Rashiq1618/SS26_Prototyping_GroupE2_Team_E1/README.md

<div align="center">

  Animated Title

<br><br>

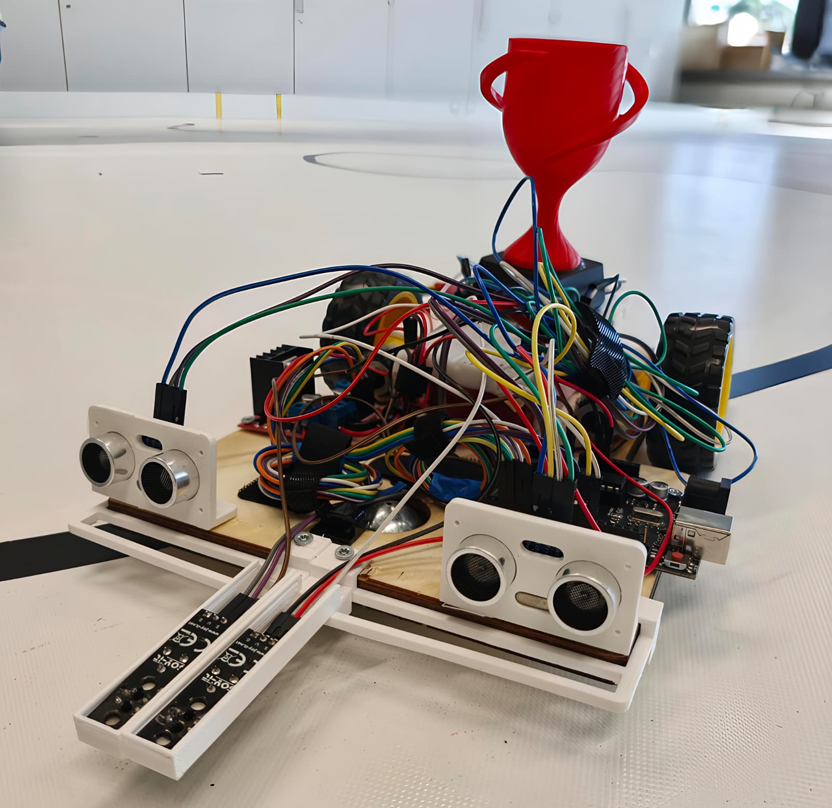
[picture p1: assets/car_trophy.jpeg]
Autonomous Driving Vehicle Prototype
  

</div>

## Project Overview

The Autonomous Driving System (ADS) is a semester project for the System Engineering & Prototyping module at Hochschule Hamm-Lippstadt. It focuses on developing a robotic vehicle that can follow a line and avoid obstacles autonomously.

## Key Features

* Lane or black-line following using infrared sensors.
* Obstacle detection using ultrasonic sensors.
* Dynamic route adjustment for obstacle avoidance.
* Continued lane following after obstacle avoidance.
* Autonomous operation without human intervention.
* Systems engineering-based development approach.
* Documentation using SysML diagrams and structured project management methods.

## Project Management
For quick access to the latest project management document:

https://1drv.ms/x/c/035C08A24CA7E184/ASZJ2ImVzpFNkjZW__nrY-E?e=hg7Izb

## Project Tasks

### Task 1: System Engineering Model

Task 1 focuses on developing the initial systems engineering model for the autonomous vehicle prototype.

Main activities include:

* Analyzing the overall Arduino car system.
* Defining system requirements.
* Identifying the main vehicle functions.
* Describing interactions between the user, vehicle, sensors, and environment.
* Creating SysML diagrams to represent system structure and behavior.

Expected SysML diagrams:

* Requirements Diagram
* Use Case Diagram
* Block Definition Diagram
* Internal Block Diagram
* Activity Diagram
* Sequence Diagram
* Package Diagram

### Task 2: Prototype Development and Simulation

Task 2 focuses on refining the system model and developing the first prototype concept.

Main activities include:

* Refining the SysML system model.
* Creating a pre-final system specification.
* Building the first prototype design.
* Simulating the Arduino car in Tinkercad.
* Testing line-following and obstacle detection behavior.
* Preparing the prototype for hardware implementation.

Expected outcomes:

* Refined SysML diagrams
* Pre-final system specification
* Tinkercad simulation
* First Arduino code version
* First wiring design
* Basic test results

**Task 2 Deadline:** 24.05.2026

## Hardware Prototype Milestones

### Milestone 1: Line Following

**Deadline:** 15.06.2026

Expected result:

* The car can detect the line.
* The car can move forward.
* The car can turn left and right based on sensor values.
* The car can follow the lane with basic stability.

### Milestone 2: Obstacle Detection

**Deadline:** 06.07.2026

Expected result:

* The car can detect obstacles in front of it.
* The car can stop or react when an obstacle is detected.
* Obstacle detection is integrated with the line-following behavior.

## Hardware Components

The prototype uses the following main hardware components:

* Arduino Uno
* Motor driver board
* DC motors
* Wheels
* Ball wheel
* IR sensors
* Ultrasonic sensors
* Battery
* Breadboard
* Jumper wires
* Chassis
* Sensor holders

## Contributors

* Naved Afridi Rashiq
* Amina Boudali
* Tanseem Farwah
* Tzuen Lin
