Rashiq1618/SS26_Prototyping_GroupE2_Team_E1/SysML Diagrams/Structure/Internal_Block_Diagram.pdf

ibd [block] Autonomous Vehicle System [Internal Structure]

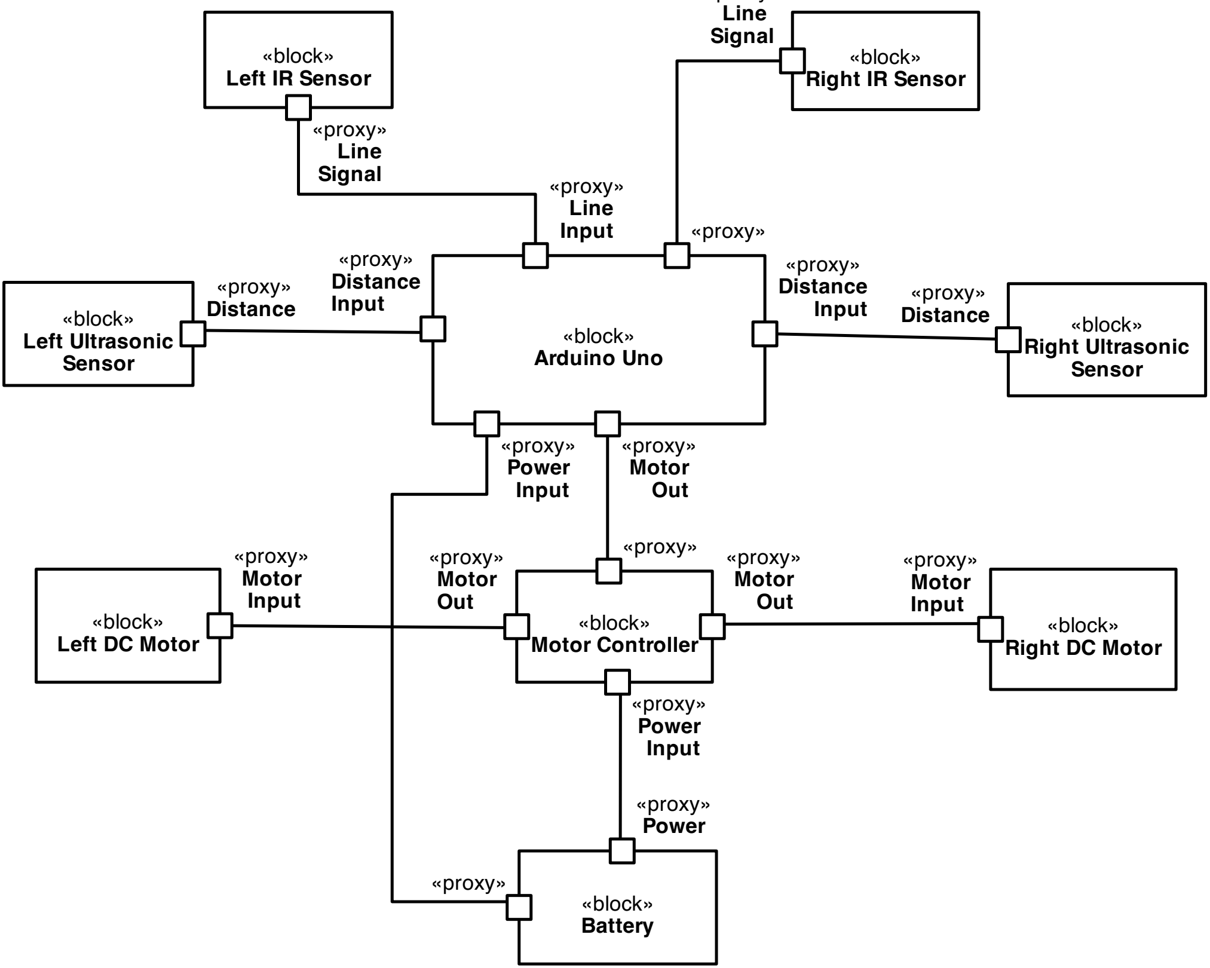
[picture p28: figure]
«block» Left IR Sensor; «proxy» Line Signal; «block» Left Ultrasonic Sensor; «proxy» Distance; «block» Right IR Sensor; Line Signal; «block» Right Ultrasonic Sensor; «block» Arduino Uno; «proxy» Motor Out; «proxy» Line Input; «proxy» Distance Input; «proxy»; «proxy» Power Input; «block» Motor Controller; «block» Left DC Motor; «proxy» Motor Input; «block» Right DC Motor; «block» Battery; «proxy» Power

«proxy»
