Rashiq1618/SS26_Prototyping_GroupE2_Team_E1/SysML Diagrams/Behavior/Use_Case_Diagram .pdf

uc Use Case Diagram

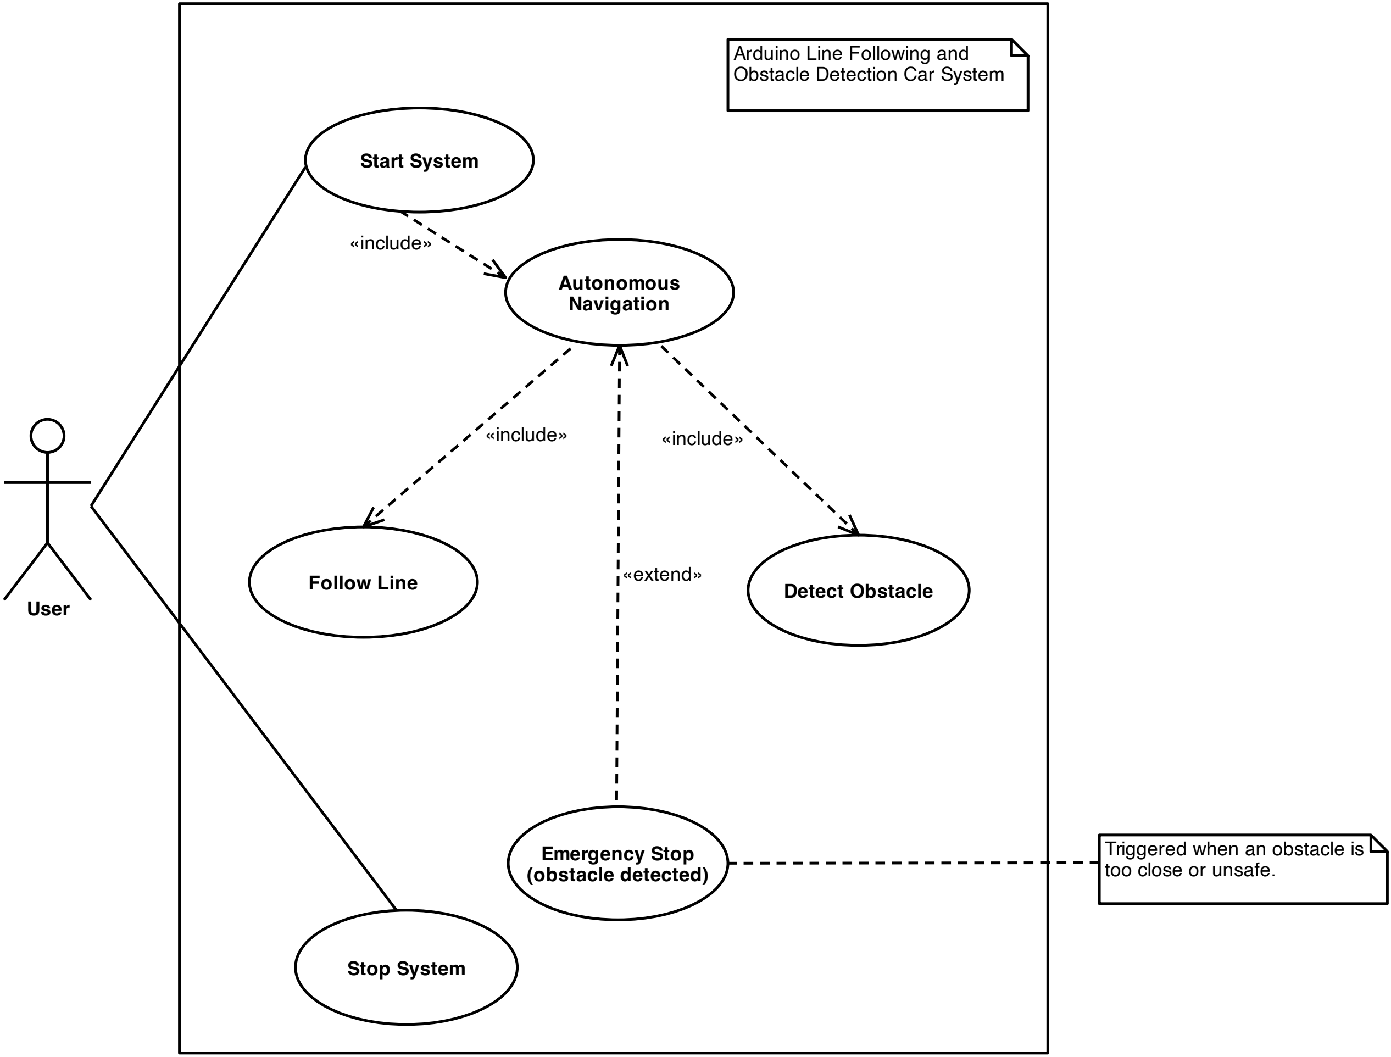
[picture p29: figure]
User; Start System; Follow Line; Detect Obstacle; Stop System; Emergency Stop (obstacle detected); Arduino Line Following and Obstacle Detection Car System; Autonomous Navigation; Triggered when an obstacle is too close or unsafe.; «include»; «extend»
