Rashiq1618/SS26_Prototyping_GroupE2_Team_E1/Project_Management/Task_Division_and_Timeline_Updated/README.md

# Project Task Division and Timeline 

## Overview

This folder contains the updated project management and task tracking documents used throughout the development of the autonomous vehicle prototype.

The updated version expands the original task division by introducing a Gantt chart timeline, improved task organization, and enhanced project monitoring.

## Features

* Task assignment and ownership tracking
* Project timeline visualization using a Gantt chart
* Progress monitoring
* Improved organization and readability
* Easier maintenance and future updates

## Dashboard Access

For quick access to the latest project management document:

https://1drv.ms/x/c/035C08A24CA7E184/ASZJ2ImVzpFNkjZW__nrY-E?e=hg7Izb
