Rashiq1618/SS26_Prototyping_GroupE2_Team_E1/Lectures/SystemsEngineering_02.pdf

Systems Engineering

Stefan Henkler | E-Mail: stefan.henkler@hshl.de
Prof. Dr. Stefan Henkler – University of Applied Sciences Hamm-Lippstadt | 17.04.2026
Faezeh Pasandideh | E-Mail: faezeh.pasandideh@hshl.de

Requirements

Models
1. Requirements Engineering
2. Requirement Specification
3. Approach: SysML
4. Discussion & Summary
5. Bibliography

2

17.04.2026

The Denver Airport Story

- Fully automated baggage system
- 2 years delay (1993 → 1995)
- $500M extra cost

Problems:
- Bags damaged / lost
- System unreliable

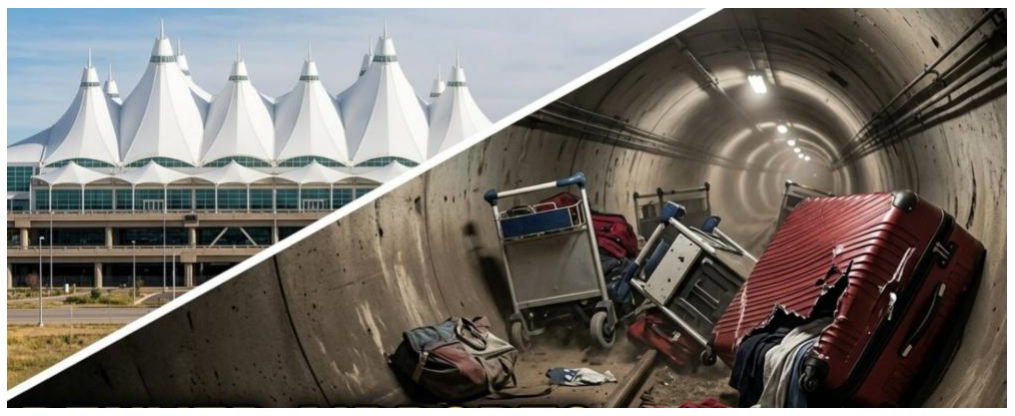
[picture p30: figure]

- https://www.youtube.com/watch?v=cnWVX0Z-OwQ

3

The Denver Airport Story

## What do you think went wrong? Why did this happen?

4

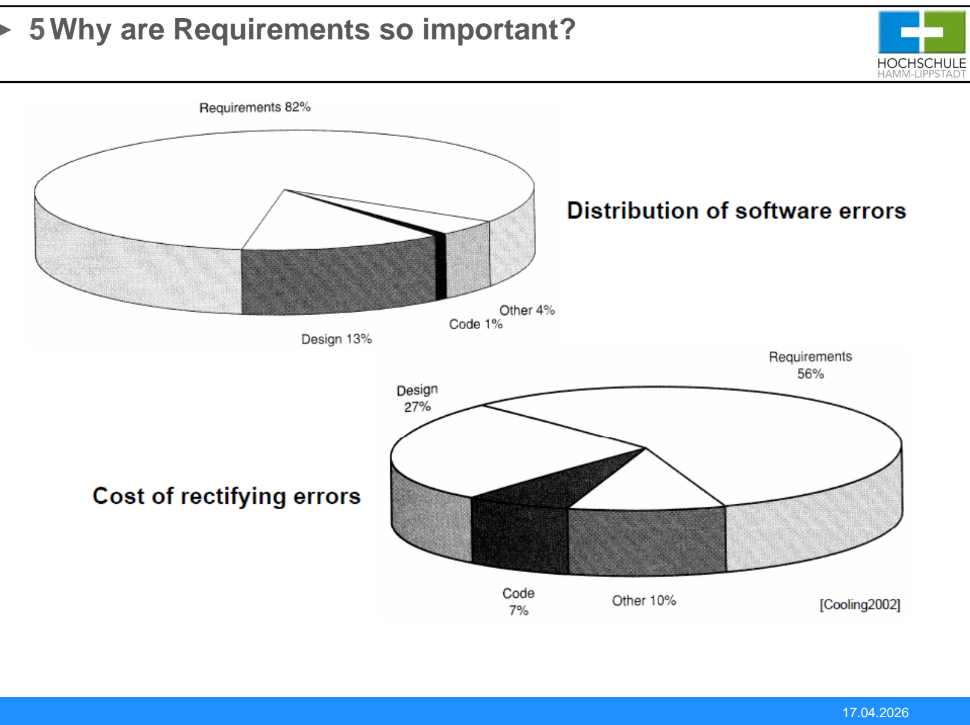
[picture p31: page 5]

5Why are Requirements so important?

Requirements

Models

6

Build a system that allows employees to submit vacation requests, and their direct manager — not HR — must approve or reject each request within 24 hours. If no action is taken in 24 hours, the request is automatically approved. The employee receives an email notification for both outcomes.

Requirements

Models

7

Please describe what you just read to your classmate.

Requirements

Models

8

Original Text: Build a system that allows employees to
submit vacation requests, and their direct | manager | — not
HR — must approve or reject each request within | 24 hours.
If no action is taken in 24 hours, the request is | automatically
approved. The employee receives an email notification for both outcomes.
- who approves (manager, not HR),
- the time limit (24 hours),
- what happens if nobody acts (auto-approve),
- and what triggers a notification (both outcomes)

What is Requirement Engineering?

Requirement Engineering (RE) is the science and discipline concerned with analyzing and documenting requirements.
Requirement:
(1) A condition or capability needed by a user to solve a problem or achieve an objective.
(2) A condition or capability that must be met or possessed by a system or system component to satisfy a contract, standard, specification, or other formally imposed documents.
(3) A documented representation of a condition or capability as in (1) or (2).

9

[IEEE-Std-610.12-1990]

The Context of Requirement Engineering The inputs and outputs

10

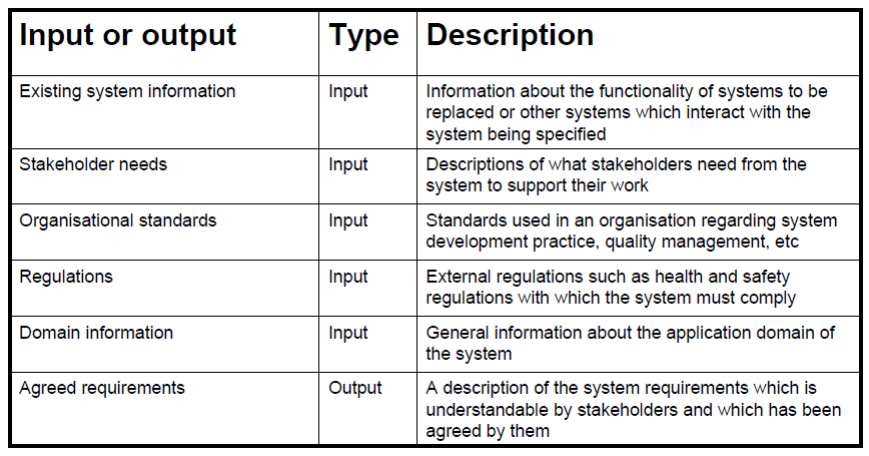
[picture p32: figure]

[Kotonya&Sommerville1998]

RE Elements

a) Requirement Elicitation (what is needed)
b) Requirement Analysis (clean & check)
c) Requirement Specification (documented)
d) Requirement Validation (confirm correctness)
e) Requirement Management (control changes over time)

11

[Thayer&Dorfman1997]

a) Requirement Elicitation

Requirement Elicitation: the process through which the customer and developer discover, review, articulate, and understand the users’ needs and constraints on the software and development activities
Requirements elicitation is about discovering what requirements a system should be based upon
This doesn’t involve just asking stakeholders what they want. It requires a careful analysis of:
- The organisation
- The application domain
- Organisation processes where the system will be used
To determine the stakeholders need.

12

[Thayer&Dorfman1997]

Stakeholders

Who are they?
Anyone with a stake in
creating or using a new
system
- Hands-on users
- Their managers
- The system administrator
- The client (system owner)
- The requirements engineer
- Other Engineers
- Software designers
- Programmers

13

Stakeholders’ backgrounds vary: they may:
come from different
departments
be trained in different
disciplines
have different (possibly
conflicting) goals
be unwilling to consider other stakeholders’ goals
have more or less political influence over requirements decisions

Elicitation Process

Establish objectives
- Business goals
- Problem to be solved
- System constraints

Understand background
- Organizational structure
- Application domain
- Existing systems

14

Organize knowledge
- Stakeholder identification
- Goal prioritization
- Domain knowledge filtering
Collect requirements
- Stakeholder requirements
- Domain requirements
- Organizational requirements

Uncovered Knowledge

Application domain knowledge
- E.g. knowledge about airport systems
Context knowledge
- E.g knowledge about Denver Airport
Problem knowledge
- E.g. knowledge about Denver’s baggage-handling system
Stakeholders needs and work processes to be supported

15

Requirements Elicitation Techniques

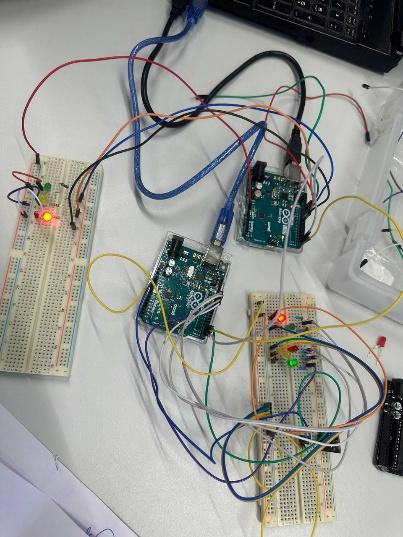
[picture p33: figure]

Interviews
Questionnaires
Examination of documentation
- Standards
- Systems manuals
- Statement of requirements
Prototyping
Conversation and interaction analysis

16

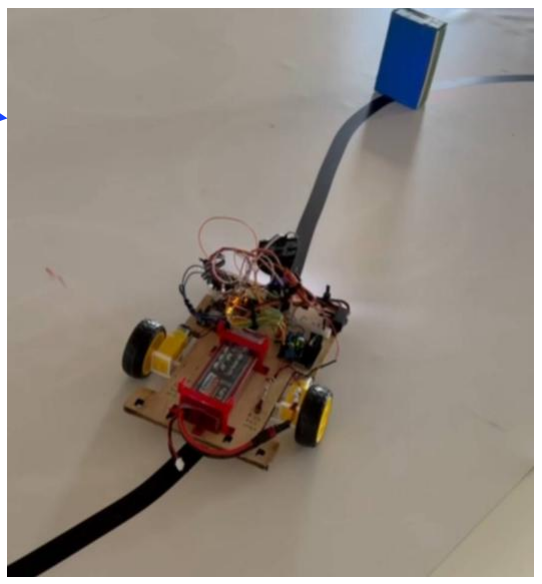
[picture p34: figure]

b) Requirement Analysis

Requirement Analysis: the process of analyzing the customers’ and users’ needs to arrive at a definition of the requirements
requirement analysis:
- (1) The process of studying user needs to arrive at a definition of system, hardware, or software requirements.
- (2) The process of studying and refining system, hardware, or software requirements.

Analyze the results of elicitation
- are the answers consistent?
- identify trouble spots
- identify boundaries
- identify most important requirements
possibly iterate over elicitation again

17

[IEEE-Std-610.12-1990]

Analysis and Negotiation

The analysis has to establish an agreed set of requirements which are complete, consistent, and unambiguous. Such a set can be used as the basis for systems development.
Negotiation: Stakeholders often disagree over requirements. Therefore they need to negotiate to try to reach agreement.

18

IV Requirements Engineering

Models
1. Requirements Engineering
2. Requirement Specification
3. Approach: SysML
4. Discussion & Summary
5. Bibliography

19 c) Requirement Specification

Requirement Specification: the development of a document that clearly and precisely records each of the requirements of the software.
Software Requirement Specification (SRS) Requirement : Specific, measurable, and testable

20

Thayer&Dorfman1997]

"The pedestrian button should work”

"After the button is pressed, the walk signal shall activate within 30 seconds”

Requirement Specification

Different specification methods have different levels of formality (precision)

Informal (Plain natural language) , Semi-formal (Structured templates, use cases, tables), Formal (Mathematical notations)
- the more formal, the more one can precisely state requirements and then verify the implemented system meets the requirements
- the more formal, the more one might be able to analyze the requirements for consistency, etc.
- the more formal, typically the more time is required for specification
- not all projects want to spend a lot of time and effort in writing requirements precisely
- particularly if requirements will change often

21

d) Requirement Validation

Requirement Validation: the process of ensuring that the requirement specification is in compliance with the user needs
system requirements, conforms to document standards, and is an adequate basis for the architectural design.

22

[Thayer&Dorfman1997]

Did we write down the right requirements?

Verification: chekcs that the code matches the spec Validation: cheks that the spec matches real human needs

e) Requirement Management

Requirement Management: the planning and controlling of the requirements elicitation, specification, analysis, and verification activities.

23

[Thayer&Dorfman1997]

Requirements for Complex Systems

A system of any but the smallest size will be decomposed into a hierarchy of elements (partitioning):
This is reflected at the requirement level by:
- (1) Allocation: assigning requirements to elements
- (2) Flowdown: requirements which respond to the allocated high level requirements
- (3) Traceability: keep track of the dependencies

24

[Thayer&Dorfman1997]

Effort Distribution for Complex Systems

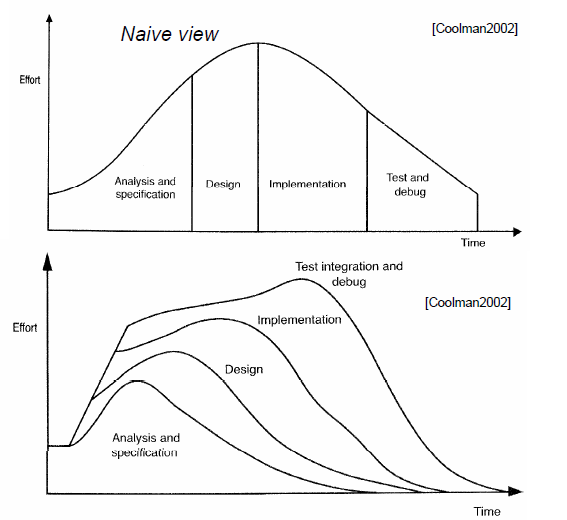
[picture p35: figure]

For complex
systems due to
allocation and
flowdown the
Requirement
engineering
continues during
the design (and
implementation)
phase

25

Requirements vs. Design

Distinction:
Design solution: HOW to achieve something Requirements: WHAT to achieve

Requirements and design solutions are sometimes mixed
- The customer mandates a design solution as a requirement
- Design solution (HOW): “provide a database for X”
- Better: ask Why!
- A derived requirement which is actually a design solution and not a requirement (depends on the perspective)
- One person’s design is the next person’s requirements

26

[Thayer&Dorfman1997]

III The Development Life Cycle

Models
1. Requirements Engineering
2. Requirement Specification
3. Approach: SysML
4. Discussion & Summary
5. Bibliography

27

SysML

System modeling language (SysML):
- defines a modeling language for systems engineering applications
- supports the specification, analysis, design, verification and validation of a range of complex systems
- Includes the possibility of representing system requirements, non-software components (mechanics, hydraulics, sensors, etc.), physical equations, continuous flows (matter, energy, etc.) and allocations
- intended to assist in integrating systems and software methodologies Who?
- International Council on Systems Engineering (INCOSE) joint with Object Management Group (OMG) in January 2001
Why Model based?
- Improved communications
- Reduced ambiguity
- Reduced errors
- More complete representation
- Enhanced knowledge capture

28

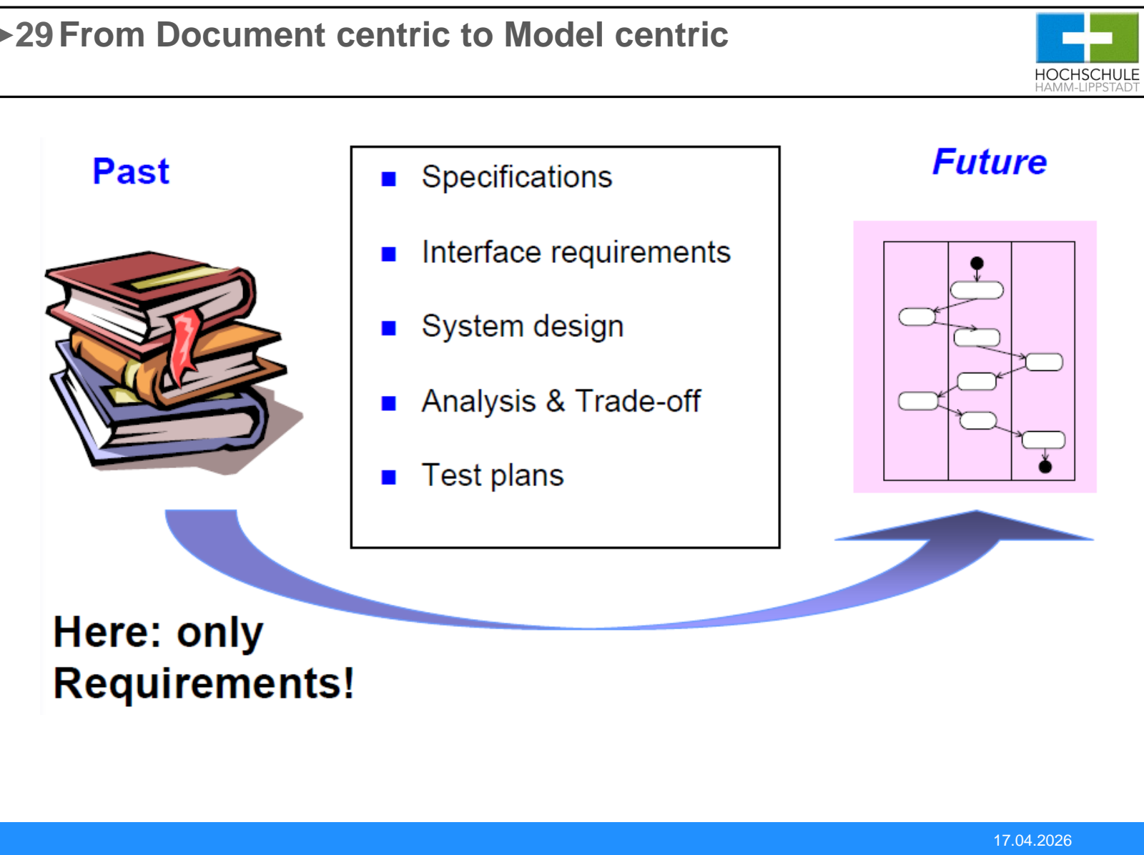
[picture p36: page 29]

29From Document centric to Model centric

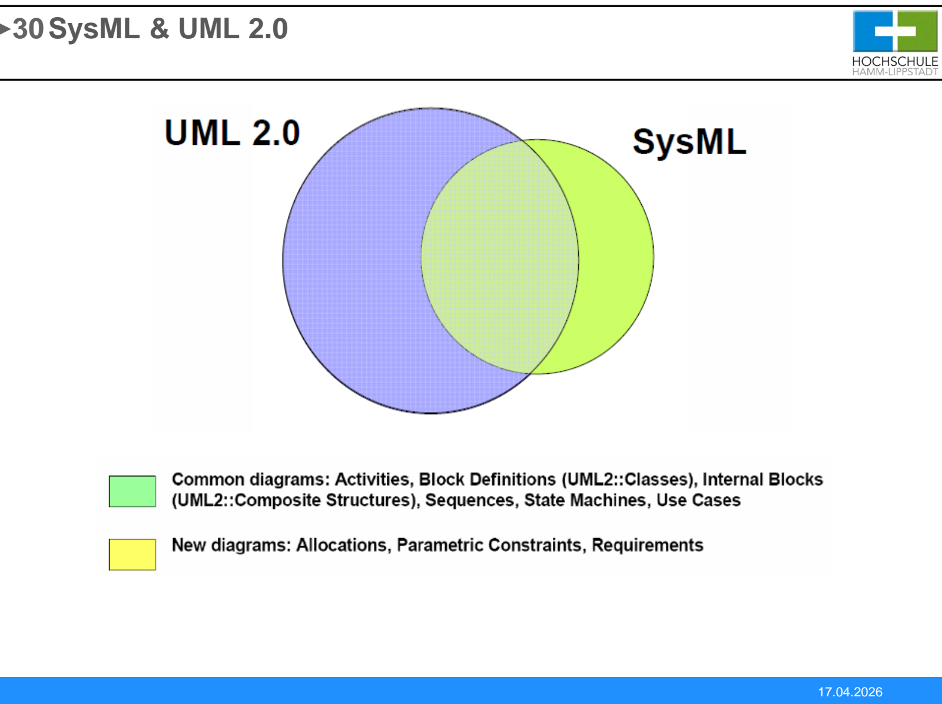
[picture p37: page 30]

30SysML & UML 2.0

SysML Diagrams

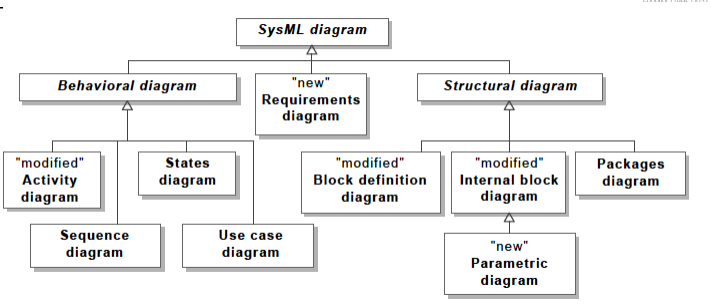
[picture p38: figure]

(1)Requirement Diagrams
(2)Use Case Diagrams
(3)Scenarios: Sequence/Activity Diagrams

31

(1) Requirement Diagram

offers a graphical representation of the requirements Basic properties of a requirement
- unique identifier
- textual description of requirement
Further properties of a requirement
- priority (e.g. high, medium or low)
- source (e.g. customer, marketing, technique and legislation)
- risk (e.g. high, medium or low)
- status (e.g. suggested, validated, implemented, tested and delivered)
- verification method (e.g. analysis, demonstration and test)

32

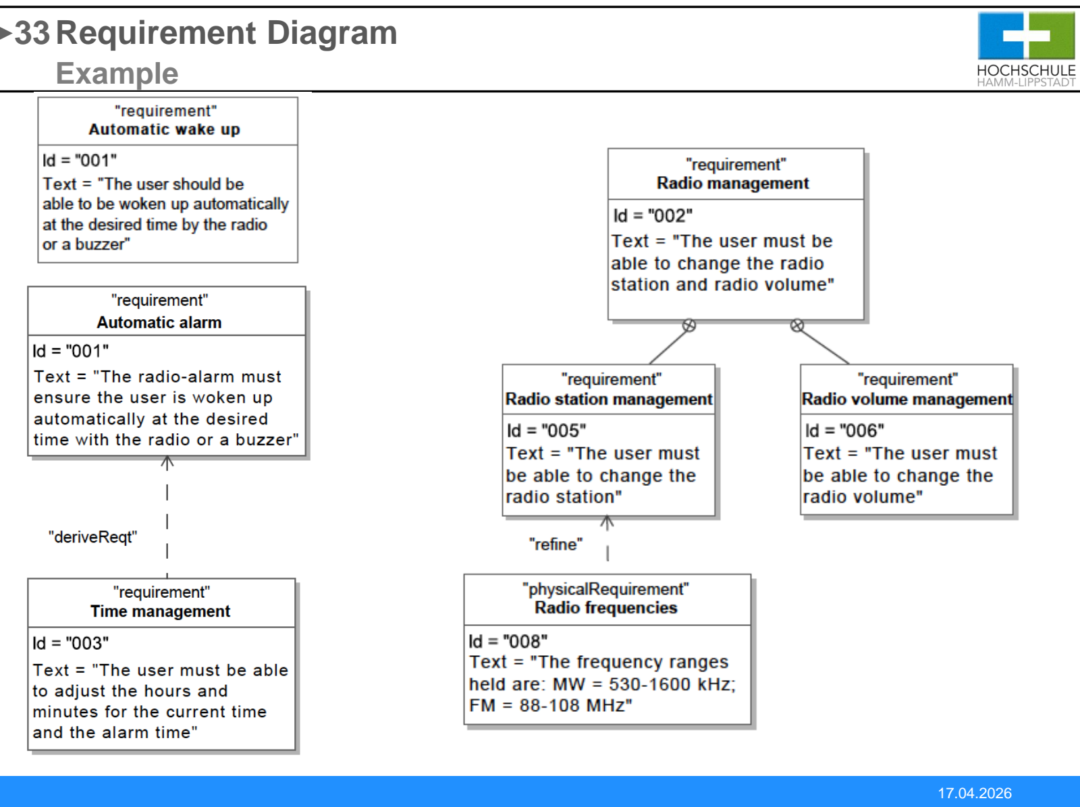
[picture p39: page 33]

Requirement Diagram

Example

33

Requirement Diagram

Containment( ): makes it possible to deconstruct a composite requirement into several single requirements, which are then easier to trace with regard to architecture and tests.
Refinement (refine): consists of adding precision: for example, quantitative data.
Derivation (deriveReqt): consists of connecting requirements from different levels: for example, connecting system requirements to requirements at the subsystem level. This generally involves making some choices in terms of architecture.

Relations – Requirement diagram specific

34

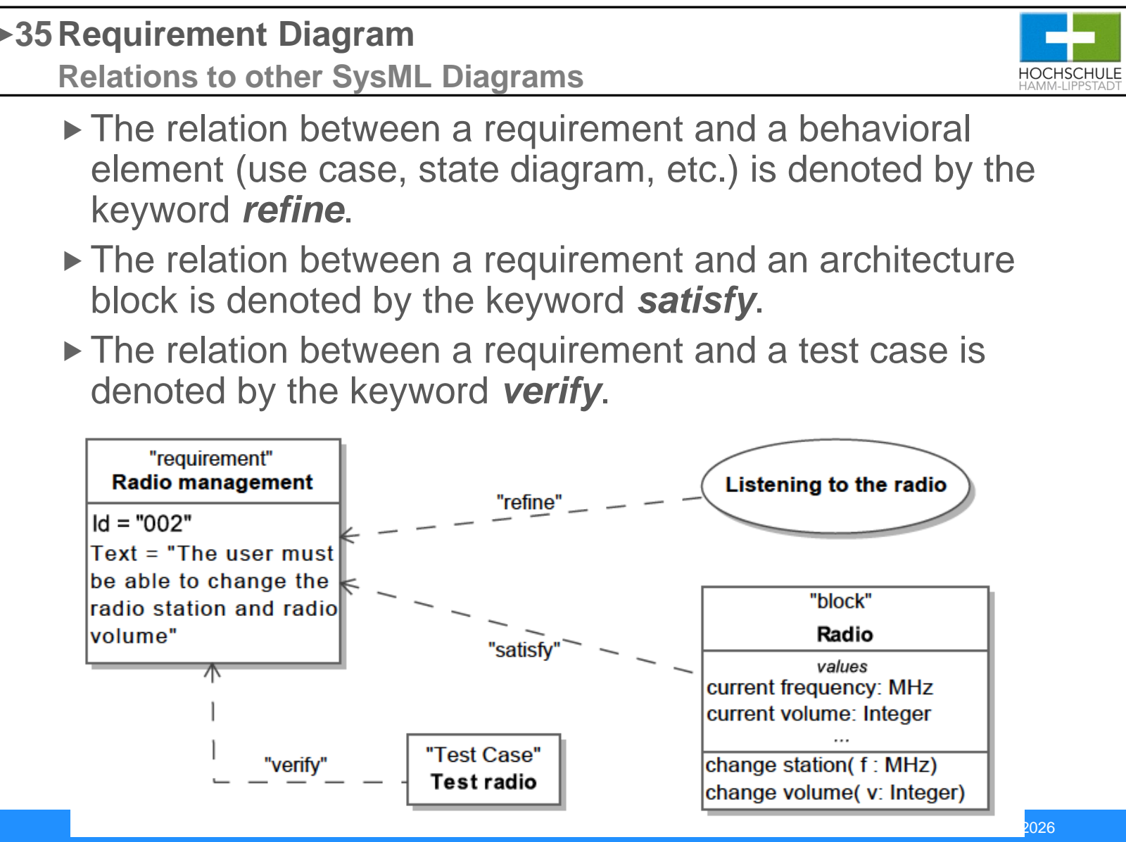
[picture p40: page 35]

Requirement Diagram

The relation between a requirement and a behavioral element (use case, state diagram, etc.) is denoted by the keyword refine.
The relation between a requirement and an architecture block is denoted by the keyword satisfy.
The relation between a requirement and a test case is denoted by the keyword verify.

Relations to other SysML Diagrams

35

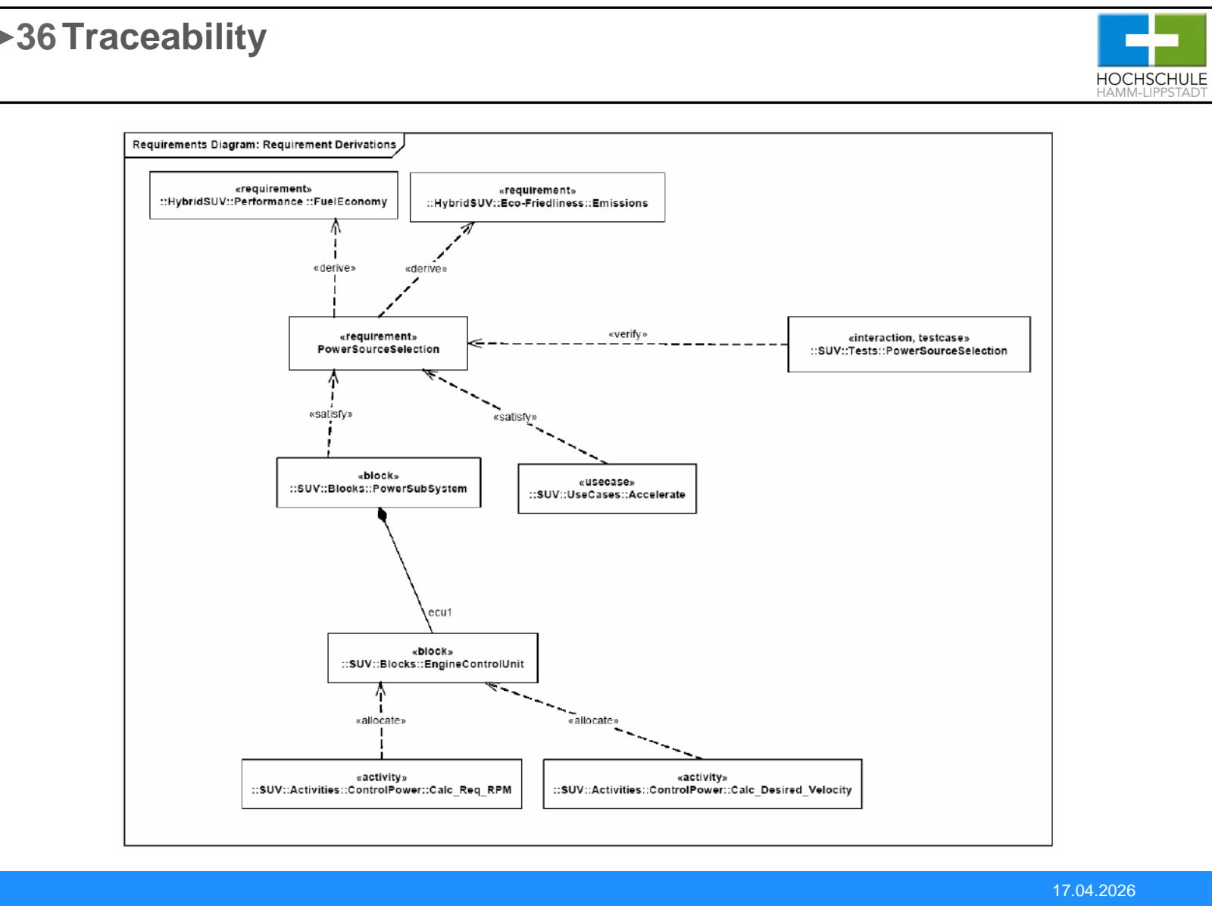
[picture p41: page 36]

36Traceability

IV. Discussion and Summary

Requirements is a crucial element of developing systems as about 80% of the software errors are located in the requirements.
The system modeling language (SysML) provides a modeling language for systems engineering applications that supports the specification and analysis of requirements and integrates systems and software methodologies.

37

III The Development Life Cycle

Models
1. Requirements Engineering
2. Requirement Specification
3. Approach: SysML
4. Discussion & Summary
5. Bibliography

38

III.7 Bibliography

[Anton+1998] A. Anton et al. The Use of Goals to Surface Requirements for Evolving Systems, International Conference on Software
Engineering, pp157-166, IEEE Comp. Soc. Press, 1998
[Cooling2002] Jim Cooling, Software Engineering for Real-time Systems. Addison Wesley, November 2002
ISBN: 0201596202
[IEEE-Std-830-1993] Standards Coordinating Committee of the IEEE Computer Society, The Institute of Electrical and Electronics Engineers, Inc., 345 East
47th Street, New York, NY 10017-2394, USA, IEEE Recommended
Practice for Software Requirements Specifications, IEEE Std 830-
1993.
[IEEE-Std-830-1998] Standards Coordinating Committee of the IEEE Computer Society, The Institute of Electrical and Electronics Engineers, Inc., 345 East
47th Street, New York, NY 10017-2394, USA, IEEE Recommended
Practice for Software Requirements Specifications, IEEE Std 830-
1998.
[IEEE-Std-1471-2000] Standards Coordinating Committee of the IEEE Computer Society, The Institute of Electrical and Electronics Engineers, Inc., 345 East
47th Street, New York, NY 10017-2394, USA, Recommended
Practice for Architectural Description of Software-Intensive Systems,
IEEE-Std-1471-2000.

39

Bibliography

[Kotonya&Sommerville1998] G. Kotonya and I. Sommerville, Requirements Engineering. John Wiley,1998. Systems
Requirements Engineering, P. Loucopoulos et al., Mc
Graw-Hill, 1995
[Lamsweerde2001] A. van Lamsweerde, Goal-Oriented Requirements Engineering: A Guided Tour, 5th International
Symposium on Requirements Engineering, IEEE
Computer Society Press, 2001
[Loucopoulos&Karakostas1995] Loucopoulos, P., and Karakostas, V., System Requirements Engineering, McGraw-Hill,1995 [Sommerville&Sawyer1997] Sommerville, I., and Sawyer, P., Requirements Engineering, John Wiley,1997
[Thayer&Dorfman1997] Software requirements engineering Thayer, Richard H. And Dorfman, Merlin [Hrsg.]:. - Los
Alamitos, Calif. [u.a.] : IEEE Computer Soc. Press ,
1997 .
ISBN: 0-8186-7738-4

40

Automotive Case Study

[1] S. Friedenthal, A. Moore, und R. Steiner, A practical guide to SysML: the systems modeling language. Waltham, MA: Morgan Kaufmann, 2012.
- Chapter 4

41

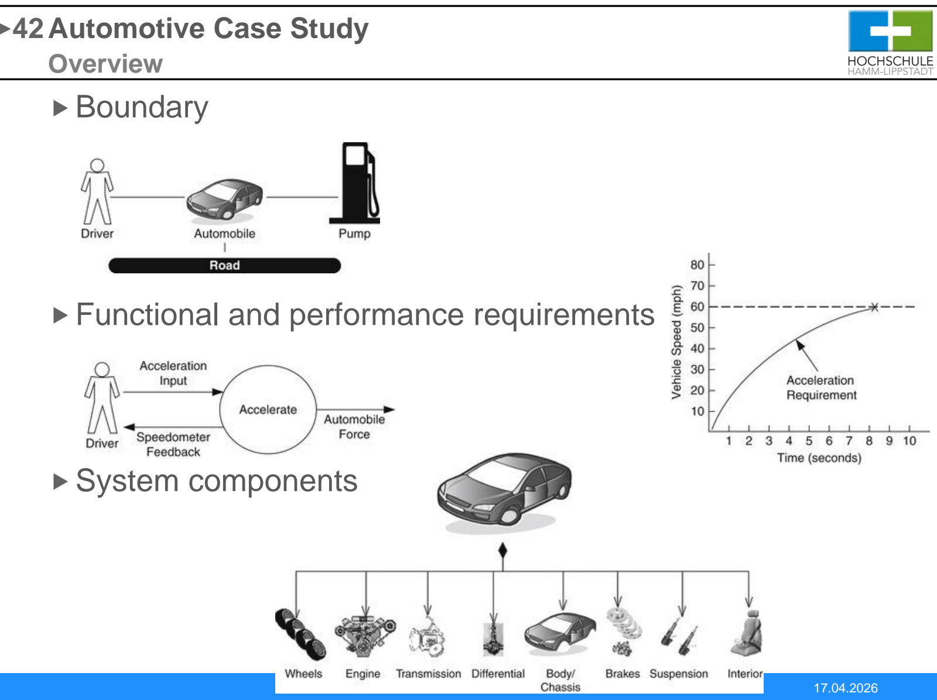
[picture p42: page 42]

Automotive Case Study

Boundary

Functional and performance requirements

System components

Overview

42

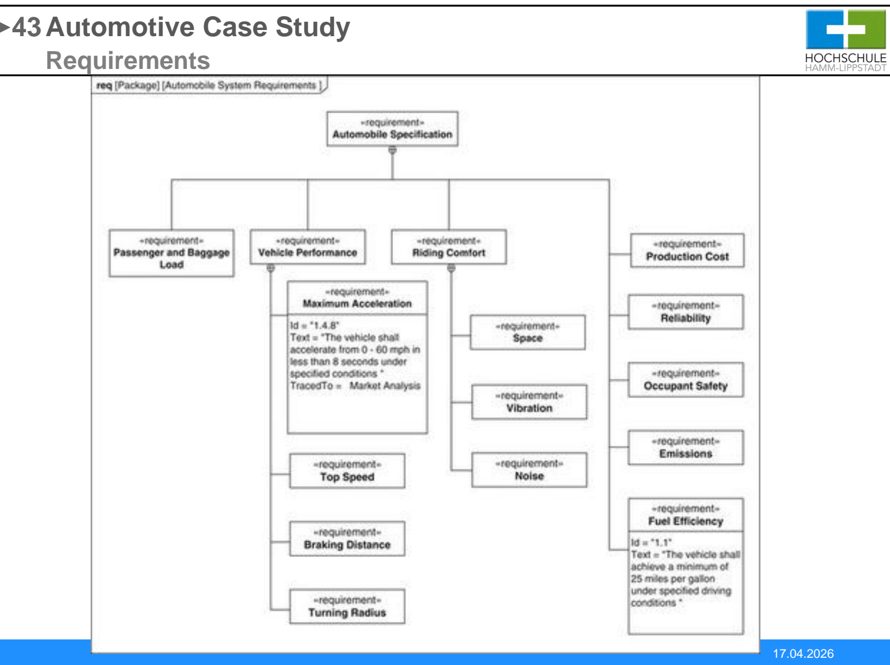
[picture p43: page 43]

Automotive Case Study
Requirements

43

Automotive Case Study

Functional Requirements

Use Cases

44

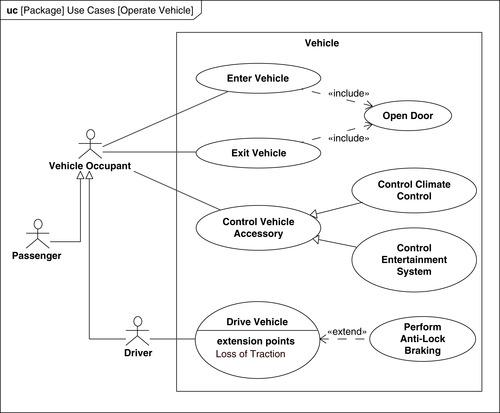
[picture p44: figure]

Automotive Case Study

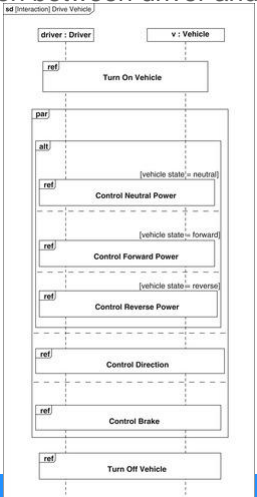
[picture p45: figure]

Interaction between driver and vehicle

Sequence Diagram

45

Practical work

Consider your Microcontroller project from last semester
- Describe the requirements with the help of SysML Requirements
- Use the reference possibilities of the SysML Requirement Diagram
- Use a tool for the specification, like draw.io (https://www.diagrams.net/)
Readings
- Tim Weilkiens,

“Systems Engineering with SysML/UML” (see: https://learning.oreilly.com/library/view/systems-engineering-with/9780123742742/) (https://learning.oreilly.com/library/view/systems-engineering-with/9780123742742/)
- Chapter 3. UML—Unified Modeling Language
- 4.1 TO 4.3. THE REQUIREMENT DIAGRAM
- 4.5. BLOCK DIAGRAMS
Prof. Dr. Stefan Henkler – University of Applied Sciences Hamm-Lippstadt | 17.04.2026 < 46 >
