Rashiq1618/SS26_Prototyping_GroupE2_Team_E1/SysML Diagrams/Behavior/Activity Diagram.pdf

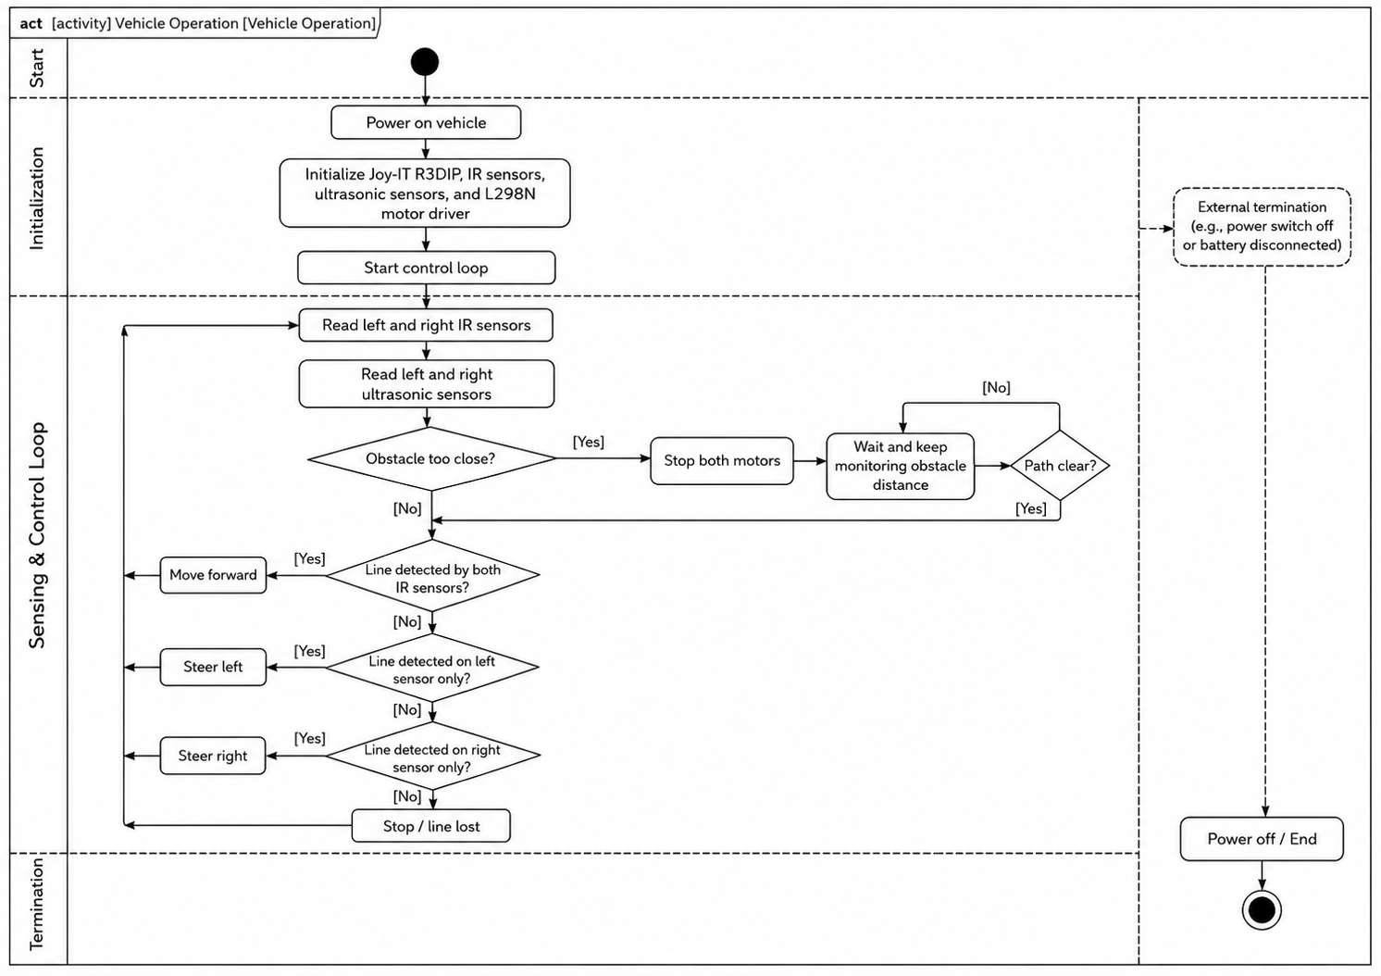
[picture p46: page 1]
