Rashiq1618/SS26_Prototyping_GroupE2_Team_E1/SysML Diagrams/Package/Package diagram.pdf

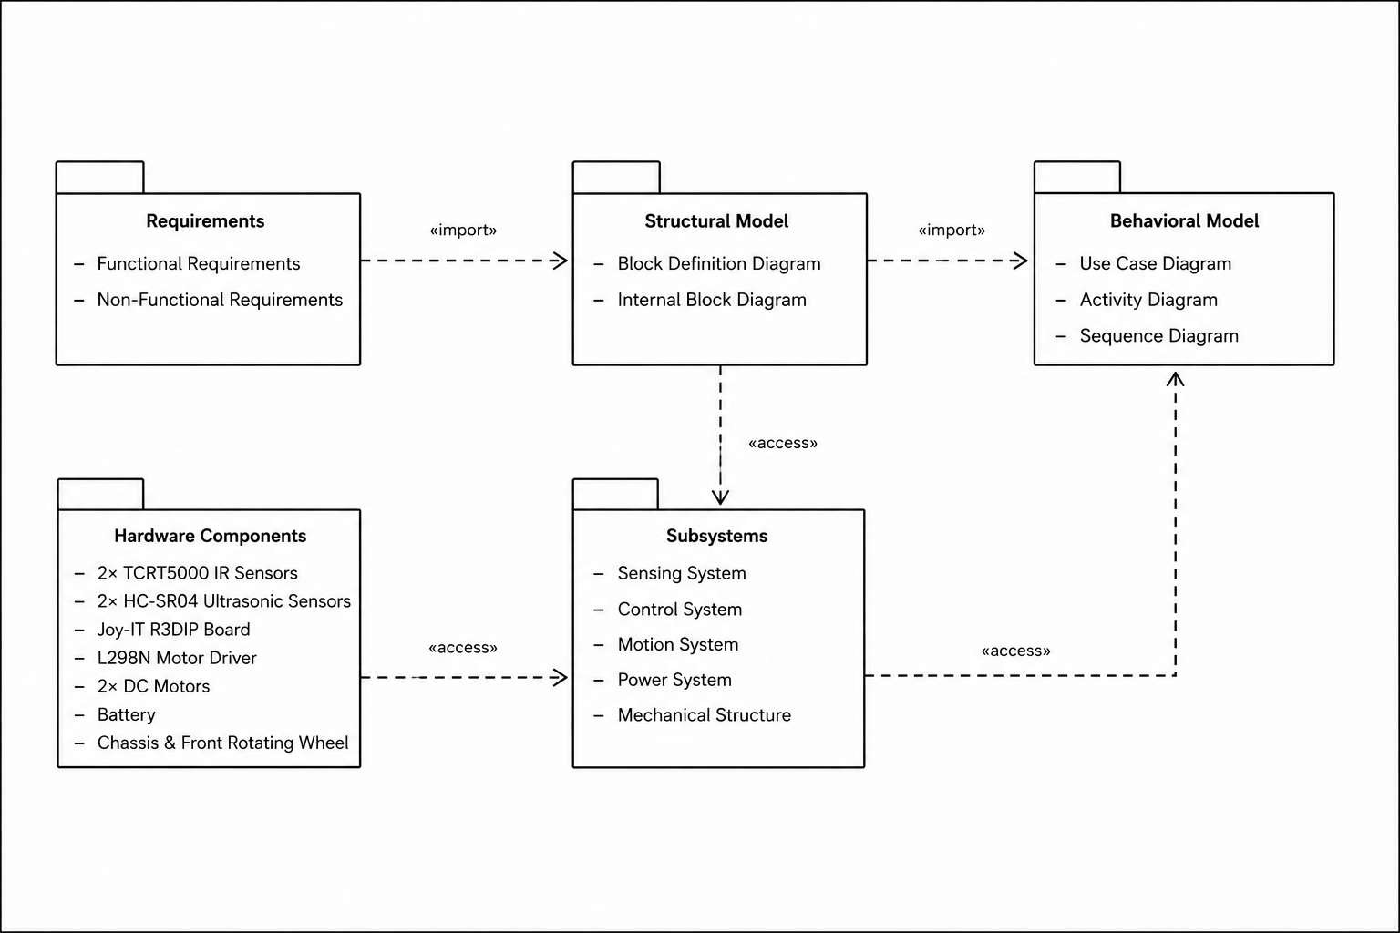
[picture p47: page 1]
