Rashiq1618/SS26_Prototyping_GroupE2_Team_E1/SysML Diagrams/Structure/Block Definition Diagram.pdf

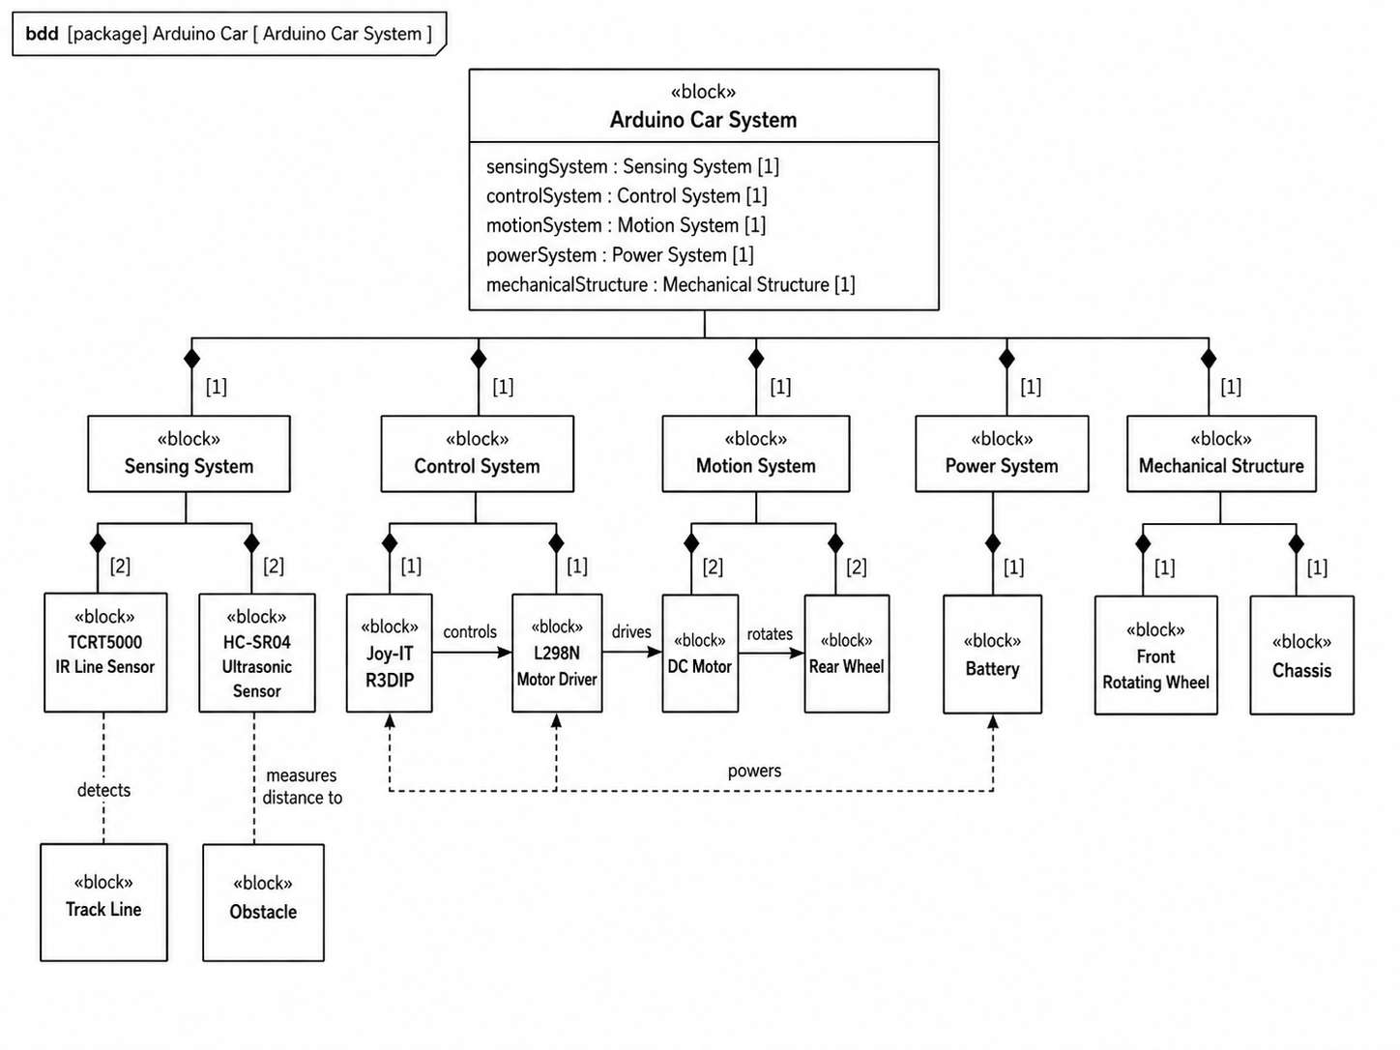
[picture p48: page 1]
