Rashiq1618/SS26_Prototyping_GroupE2_Team_E1/Electrical_Design/connection-table.jpeg

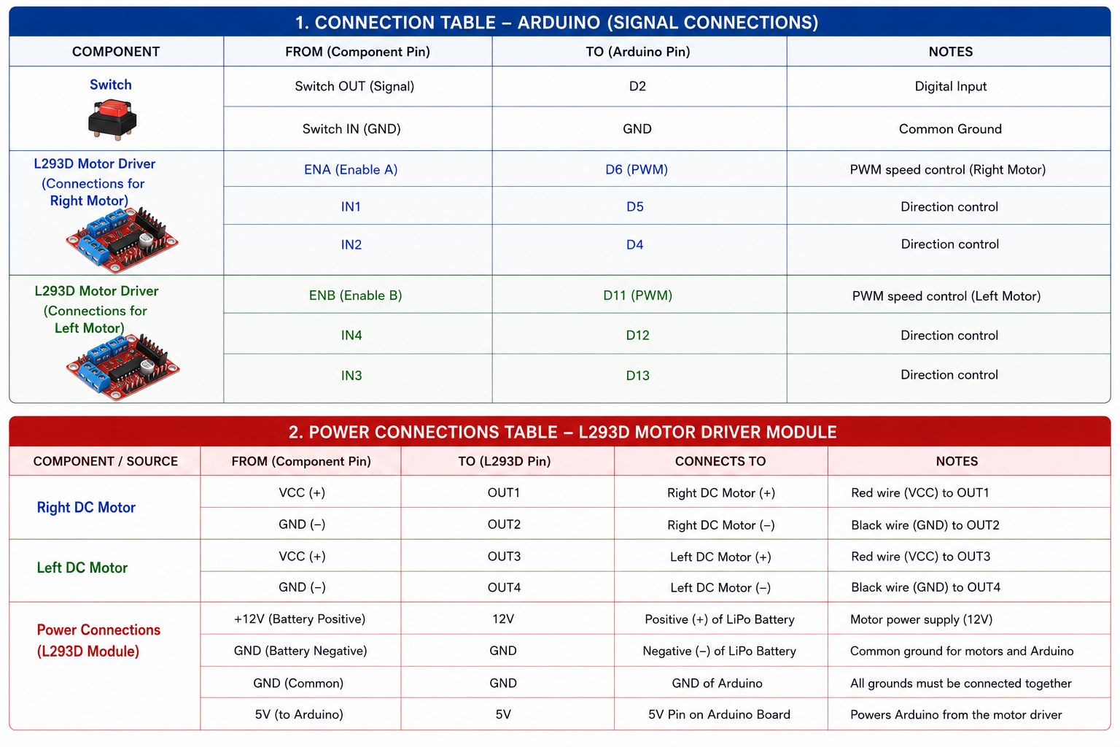
Electrical_Design/connection-table.jpeg
