Rashiq1618/SS26_Prototyping_GroupE2_Team_E1/Electronics/power-circuit.png

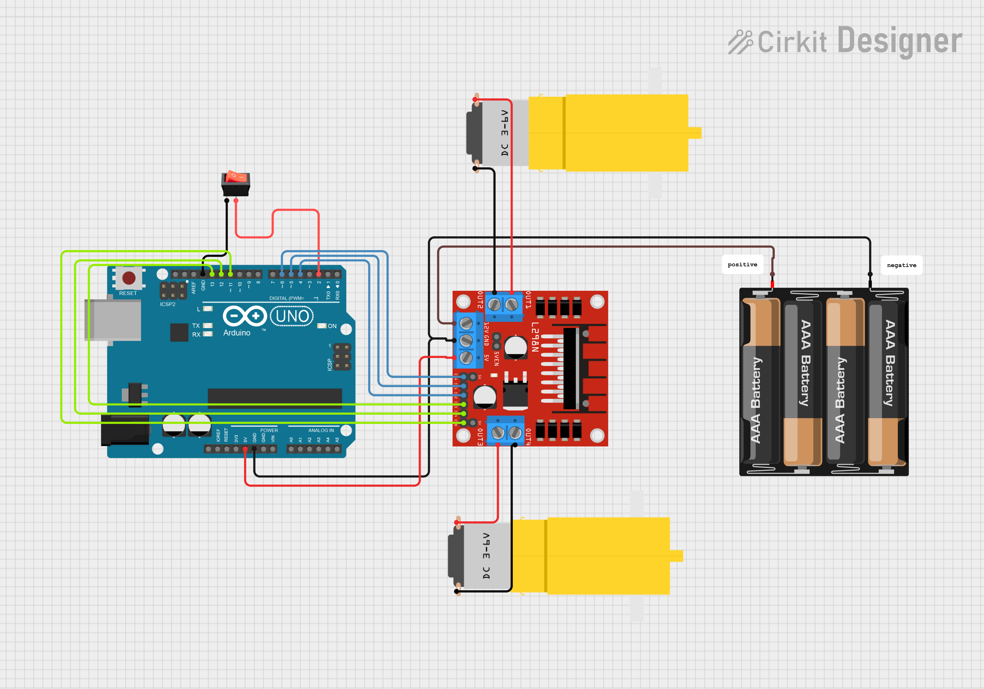
Electronics/power-circuit.png
