Rashiq1618/SS26_Prototyping_GroupE2_Team_E1/Simulations/tinkercad-circuit.png

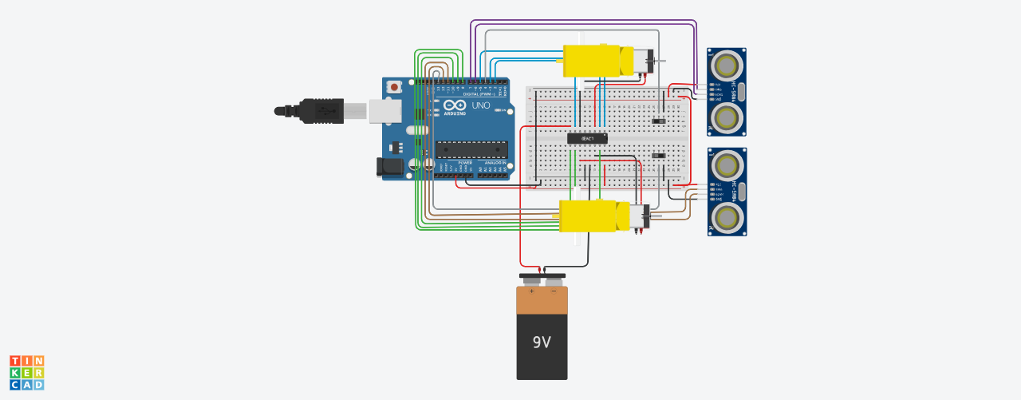
Simulations/tinkercad-circuit.png
