Rashiq1618/SS26_Prototyping_GroupE2_Team_E1/Component_Holder_Designs/E1_GROUP_E2_IR_Sensor_holder_2x.stl

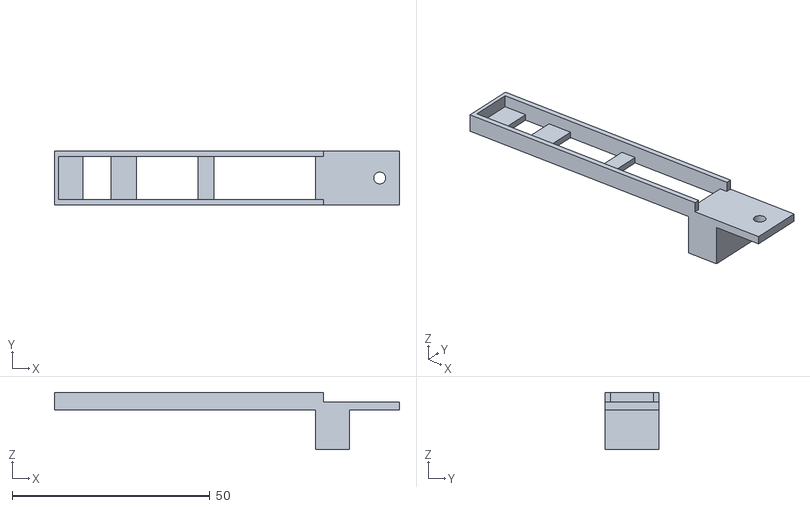
[picture p52: CAD file, 2026-05-18]
Component_Holder_Designs/E1_GROUP_E2_IR_Sensor_holder_2x.stl
87.2 x 13.7 x 14.5
