Rashiq1618/SS26_Prototyping_GroupE2_Team_E1/Component_Holder_Designs/E1_GROUP_E2_Motor_Holder_Left.stl

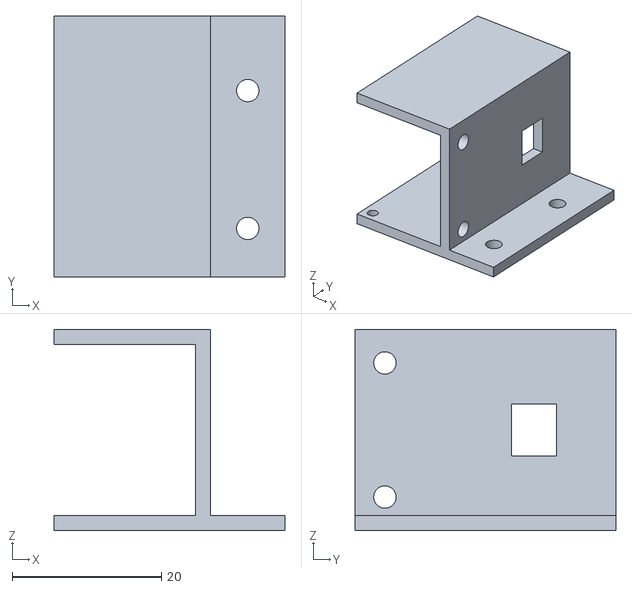
[picture p54: CAD file, 2026-05-18]
Component_Holder_Designs/E1_GROUP_E2_Motor_Holder_Left.stl
31.0 x 35.0 x 27.0
