Rashiq1618/SS26_Prototyping_GroupE2_Team_E1/Component_Holder_Designs/E1_GROUP_E2_Battery_Holder_right.STL

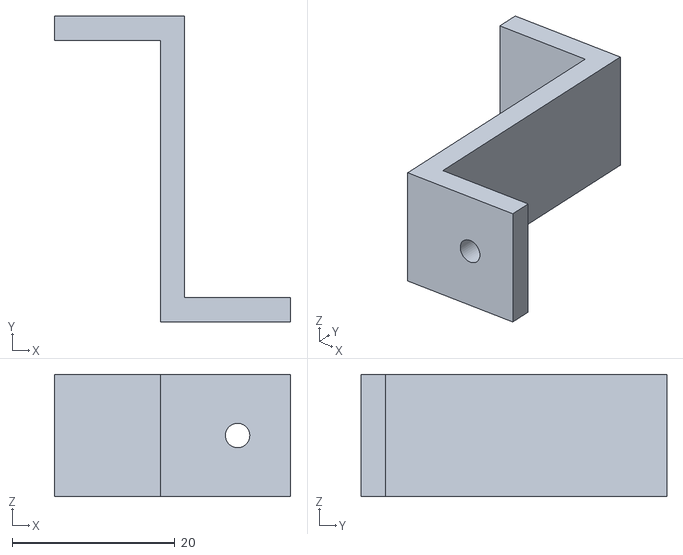
[picture p55: CAD file, 2026-05-12]
Component_Holder_Designs/E1_GROUP_E2_Battery_Holder_right.STL
29.0 x 37.6 x 15.0
