Rashiq1618/SS26_Prototyping_GroupE2_Team_E1/Component_Holder_Designs/E1_GROUP_E2_IR_Holder.stl

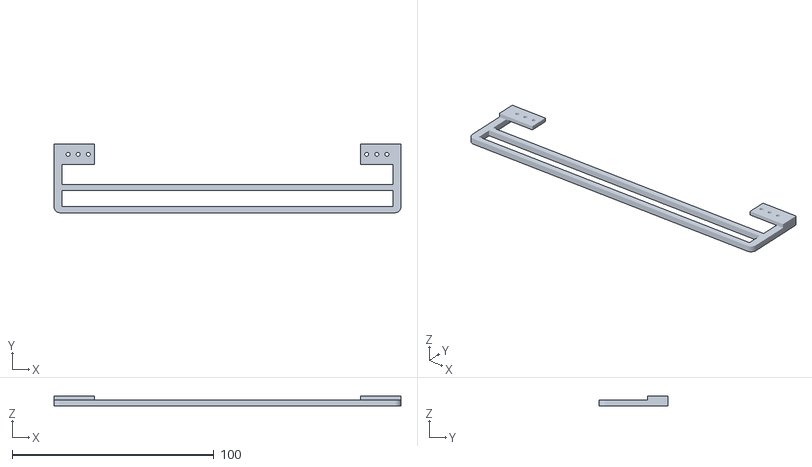
[picture p56: CAD file, 2026-05-12]
Component_Holder_Designs/E1_GROUP_E2_IR_Holder.stl
172.0 x 34.0 x 5.00
