Rashiq1618/SS26_Prototyping_GroupE2_Team_E1/Component_Holder_Designs/E1_GROUP_E2_Ultrasonic_Sensors_2x.3mf

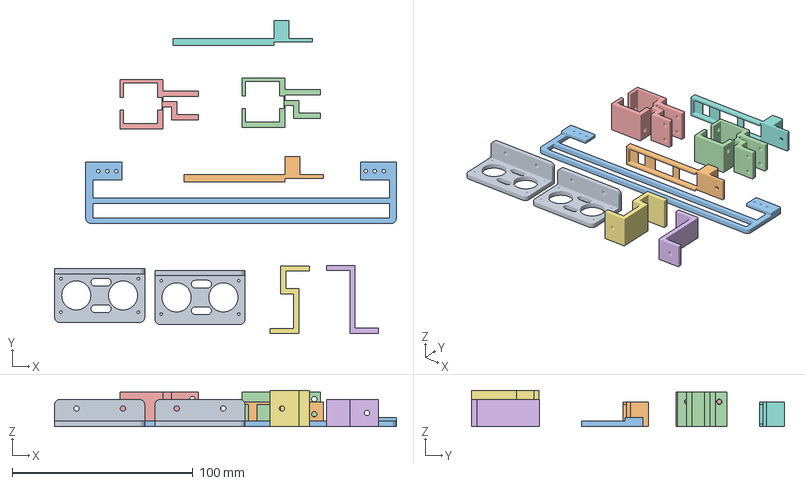
[picture p57: CAD file, 2026-05-12]
Component_Holder_Designs/E1_GROUP_E2_Ultrasonic_Sensors_2x.3mf
189.3 x 173.5 x 20.0 mm
E1_GROUP_E2_Ultrasonic_Sensors_2x.STL x 2
E1_GROUP_E2_IR_Sensor_holder_2x.stl x 2
E1_GROUP_E2_IR_Holder.stl
E1_GROUP_E2_Motor_Holder_right.STL
E1_GROUP_E2_Motor_Holder_Left.STL
E1_GROUP_E2_Battery_Holder_right.STL
E1_GROUP_E2_Battery_Holder_left.STL
