Rashiq1618/SS26_Prototyping_GroupE2_Team_E1/Component_Holder_Designs/E1_GROUP_E2_Battery_Holder_left.STL

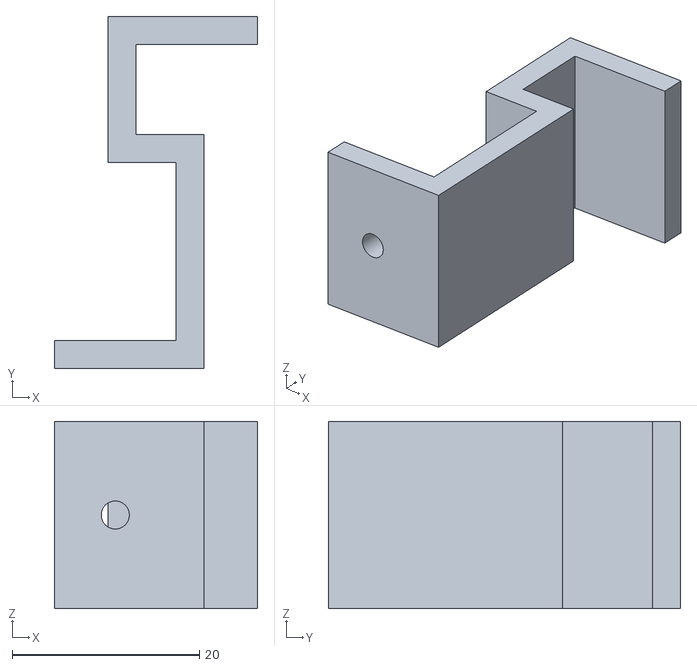
[picture p58: CAD file, 2026-05-12]
Component_Holder_Designs/E1_GROUP_E2_Battery_Holder_left.STL
21.7 x 37.6 x 20.0
