Rashiq1618/SS26_Prototyping_GroupE2_Team_E1/(list of files, cad)

Other CAD files:
Component_Holder_Designs/E1_GROUP_E2_Ultrasonic_Sensors_2x.STL
