Rashiq1618/SS26_Prototyping_GroupE2_Team_E1/Assembly/Final/1.jpeg

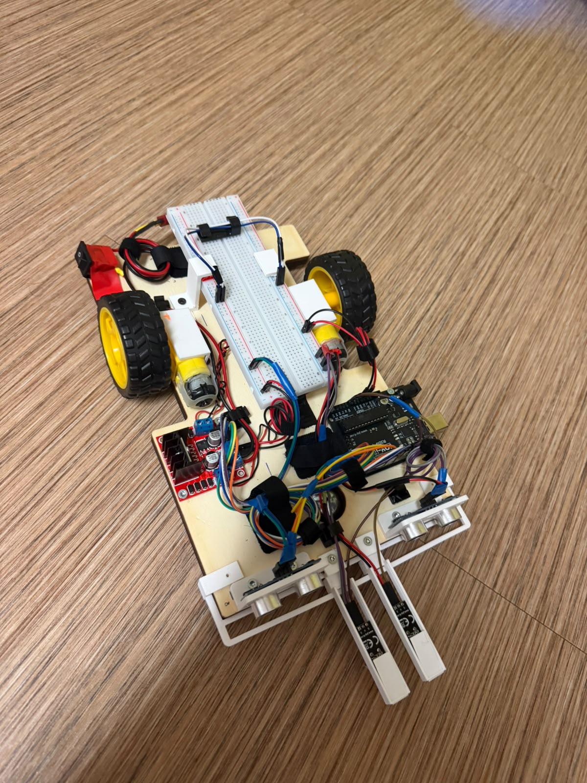
Assembly/Final/1.jpeg
