Rashiq1618/SS26_Prototyping_GroupE2_Team_E1/Assembly/Final/2.jpeg

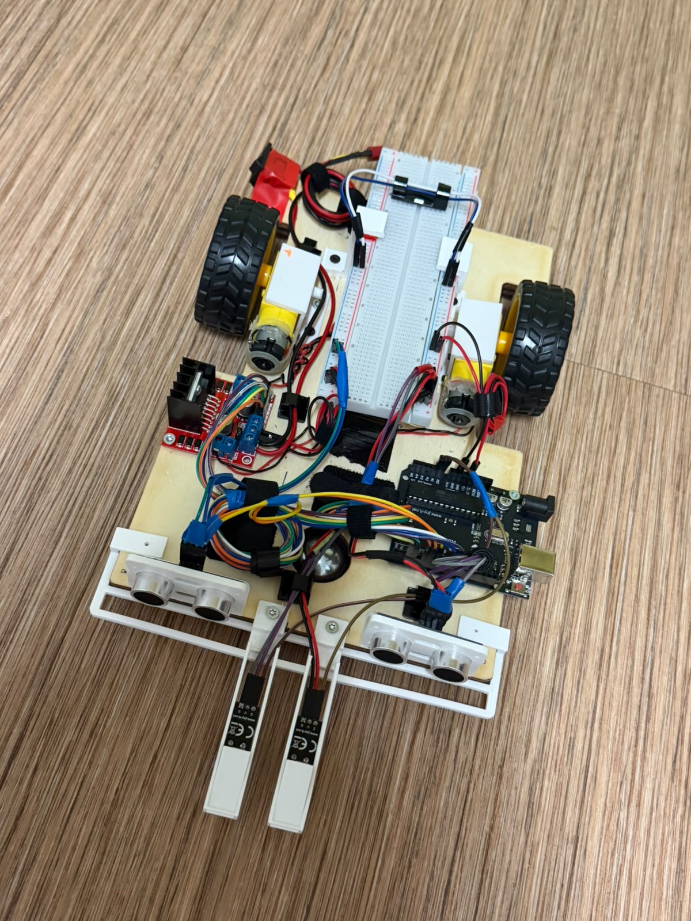
Assembly/Final/2.jpeg
