Rashiq1618/SS26_Prototyping_GroupE2_Team_E1/Assembly/Prototype/2.jpg

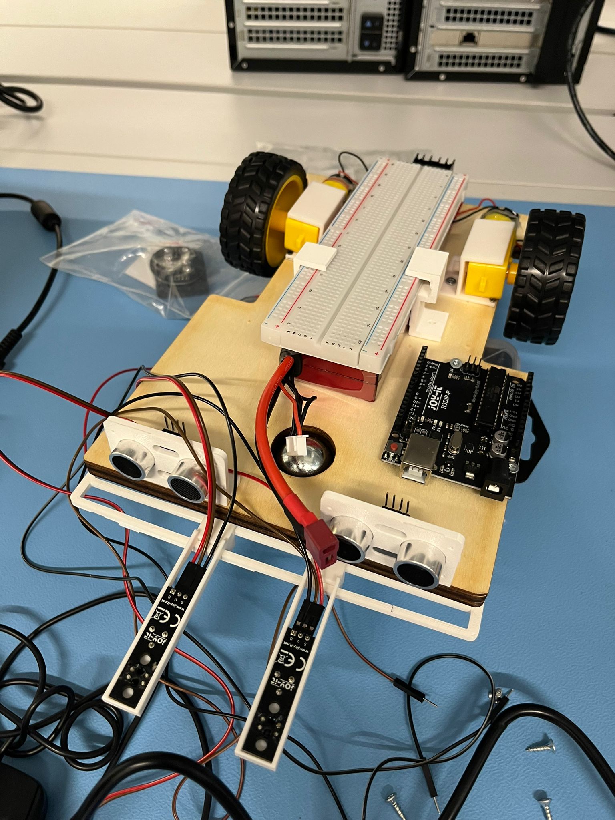
Assembly/Prototype/2.jpg
