Rashiq1618/SS26_Prototyping_GroupE2_Team_E1/SysML Diagrams/Behavior/Sequence_Diagram.pdf

## Sequence Diagram [interaction between components]

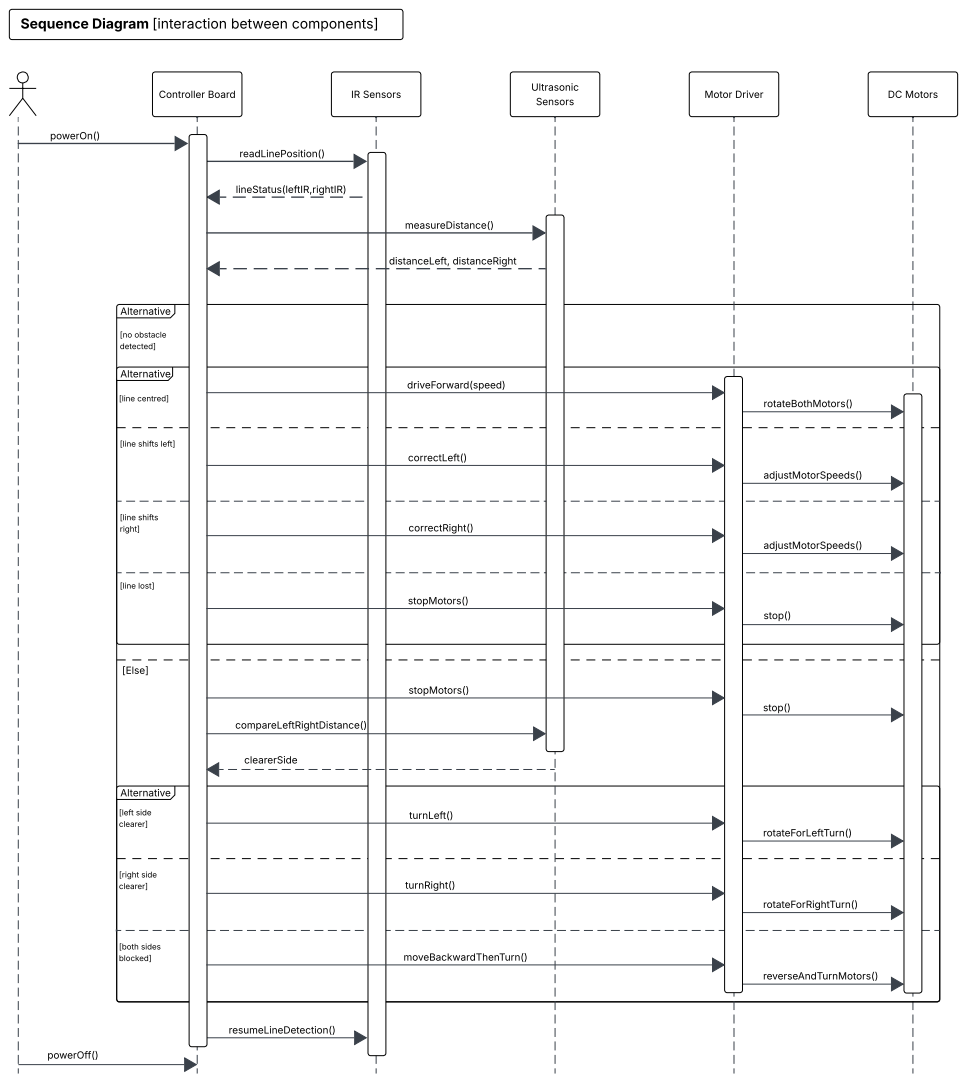
[picture p65: page 1]
Alternative; [Else]; Controller Board; IR Sensors; Ultrasonic Sensors; Motor Driver; DC Motors; powerOn(); readLinePosition(); [no obstacle detected]; [line centred]; rotateBothMotors(); adjustMotorSpeeds(); [line shifts right]; [line lost]; stop(); clearerSide; [left side clearer]; [right side clearer]; [both sides blocked]; rotateForLeftTurn(); rotateForRightTurn(); reverseAndTurnMotors(); turnRight(); resumeLineDetection(); compareLeftRightDistance(); stopMotors(); correctRight()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

lineStatus(leftIR,rightIR)

[line shifts left]
