Rashiq1618/SS26_Prototyping_GroupE2_Team_E1/Simulations/tinkercad-schematic.pdf

A

1 | 2 | 3 | 4 | 5 | 6

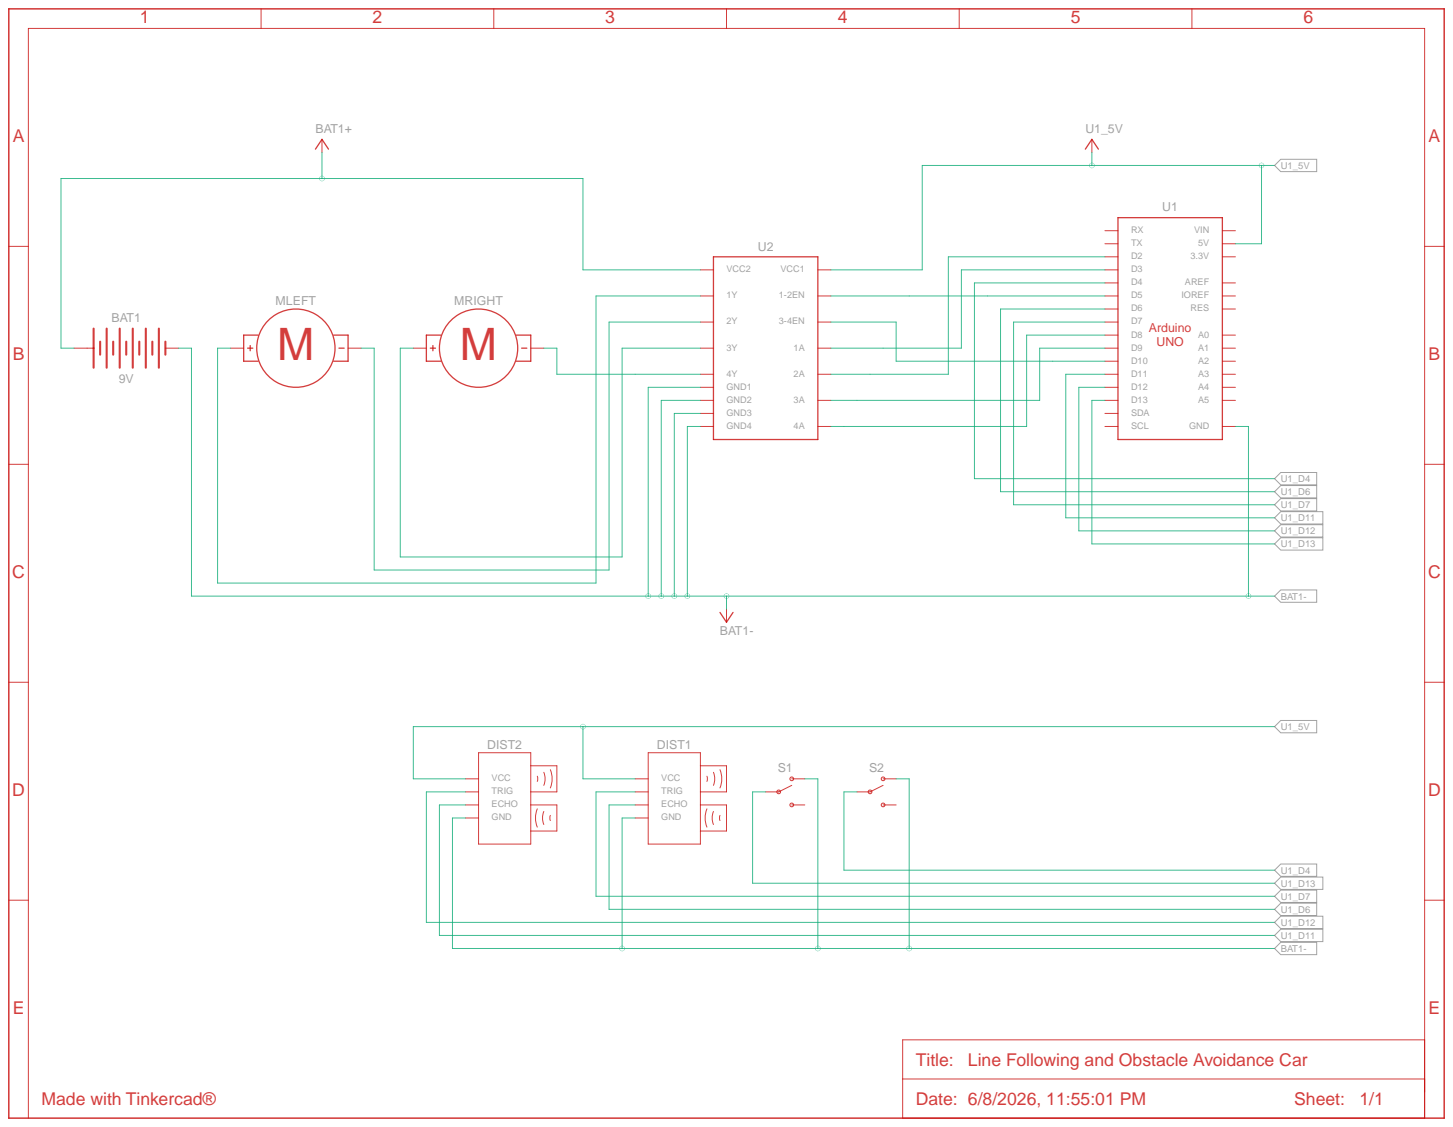
[picture p66: page 1]

Title: Line Following and Obstacle Avoidance Car
