Rashiq1618/SS26_Prototyping_GroupE2_Team_E1/(commit log)

2026-05-12 Initialize README with project details and tasks
    Added project overview, team rules, tasks, milestones, and hardware components for the Arduino car project.
2026-05-12 Add test file with sample content
2026-05-24 Add README for SysML diagrams of Arduino project
    This README provides an overview of the SysML diagrams for the Arduino line following and obstacle detection car project, including the purpose of each diagram and the repository structure.
2026-06-05 Refined README
    Updated project overview, key features, and task details for the Arduino car project.
2026-06-08 Update tinkercad-code.cpp
    I changed the direction of the motor because it was going backward instead of forward.
